dustin-lehmann/scioi-robochallenge-hub/hardware/rev1/docs/robochallenge-hub_rev1_schematics.pdf

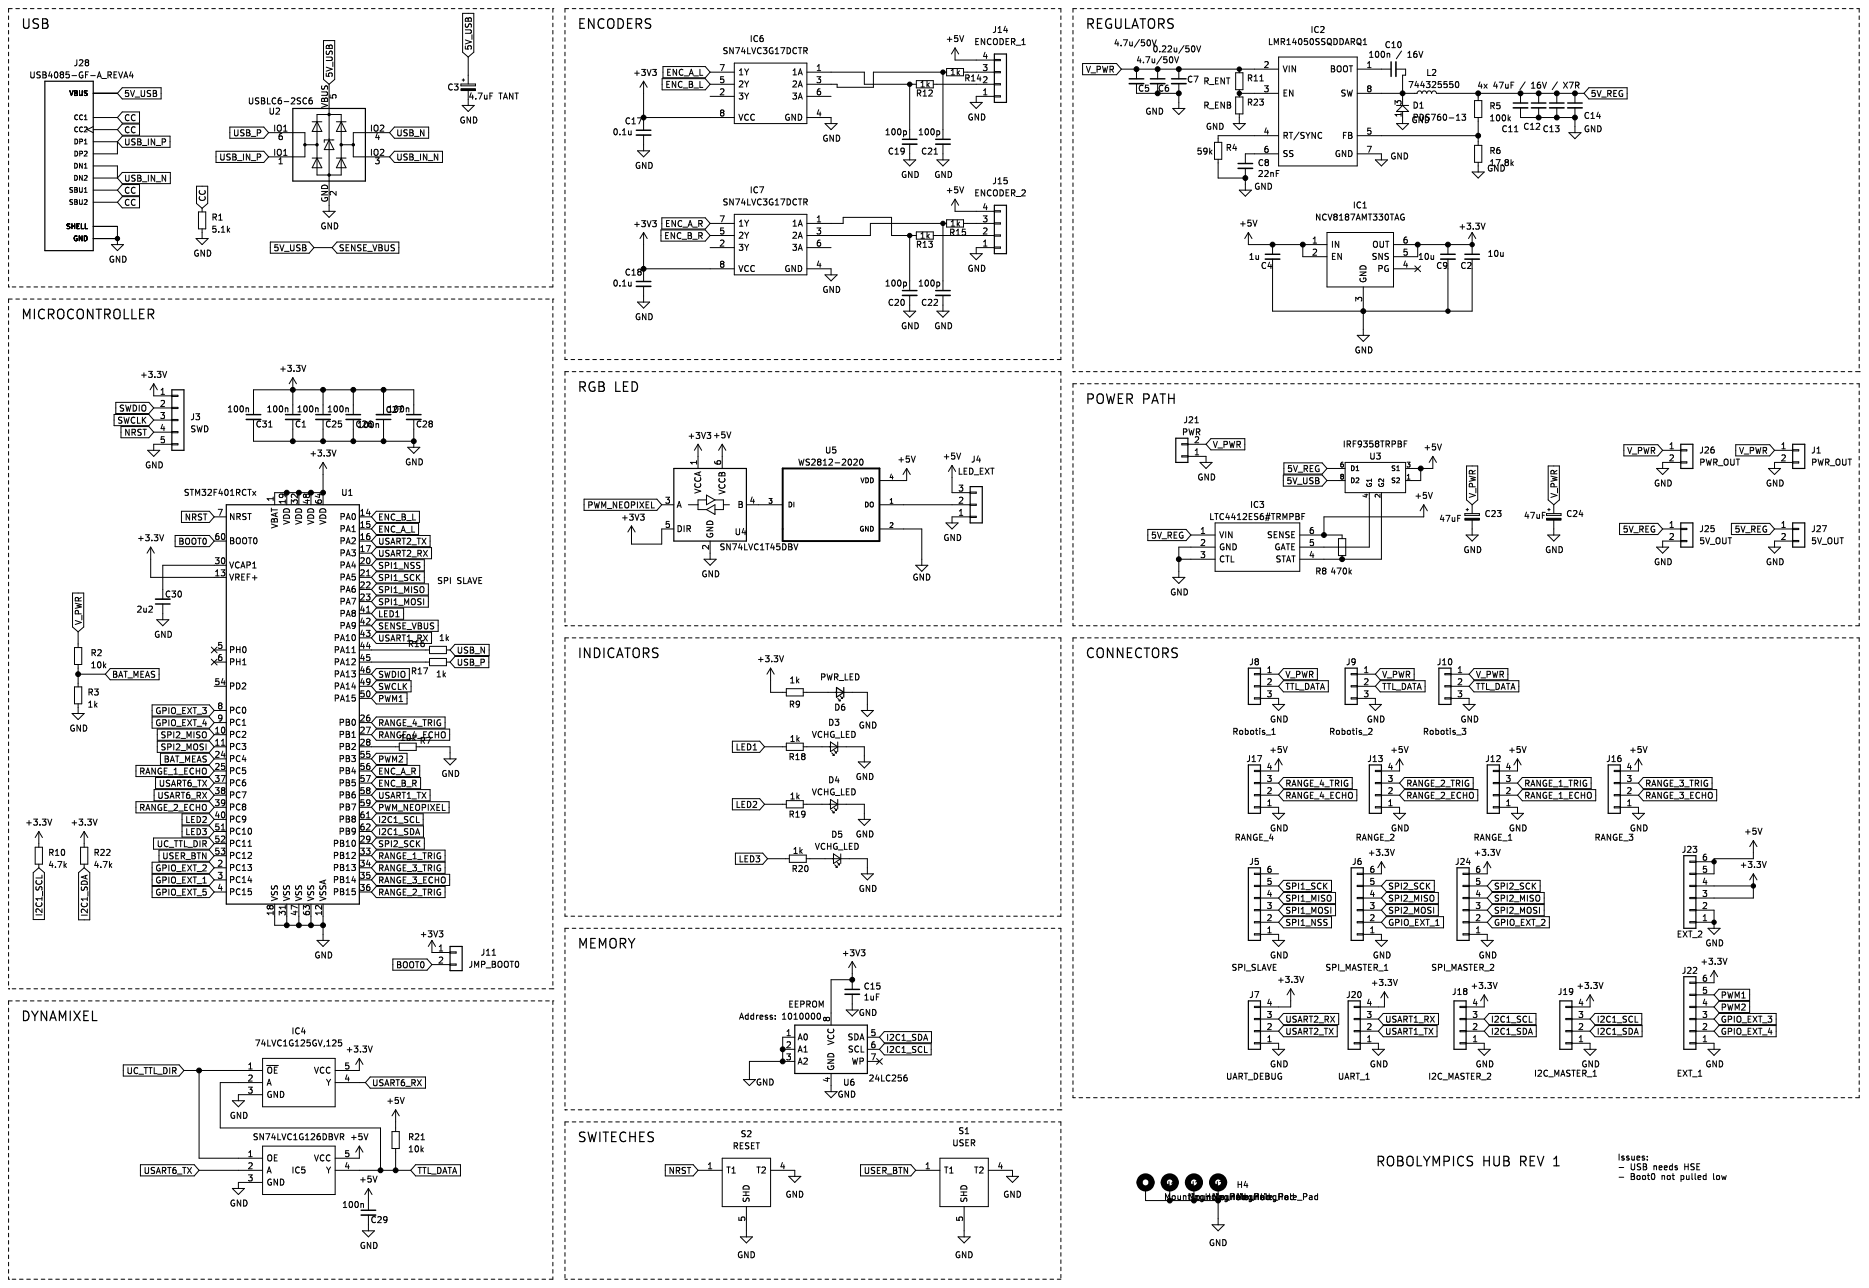
[picture p1: page 1]
