dustin-lehmann/scioi-robochallenge-hub/hardware/rev2/kicad/robolympics_hub_rev2.kicad_pcb

## KiCad design hardware/rev2/kicad/robolympics_hub_rev2.kicad_pcb (2022-03-09)

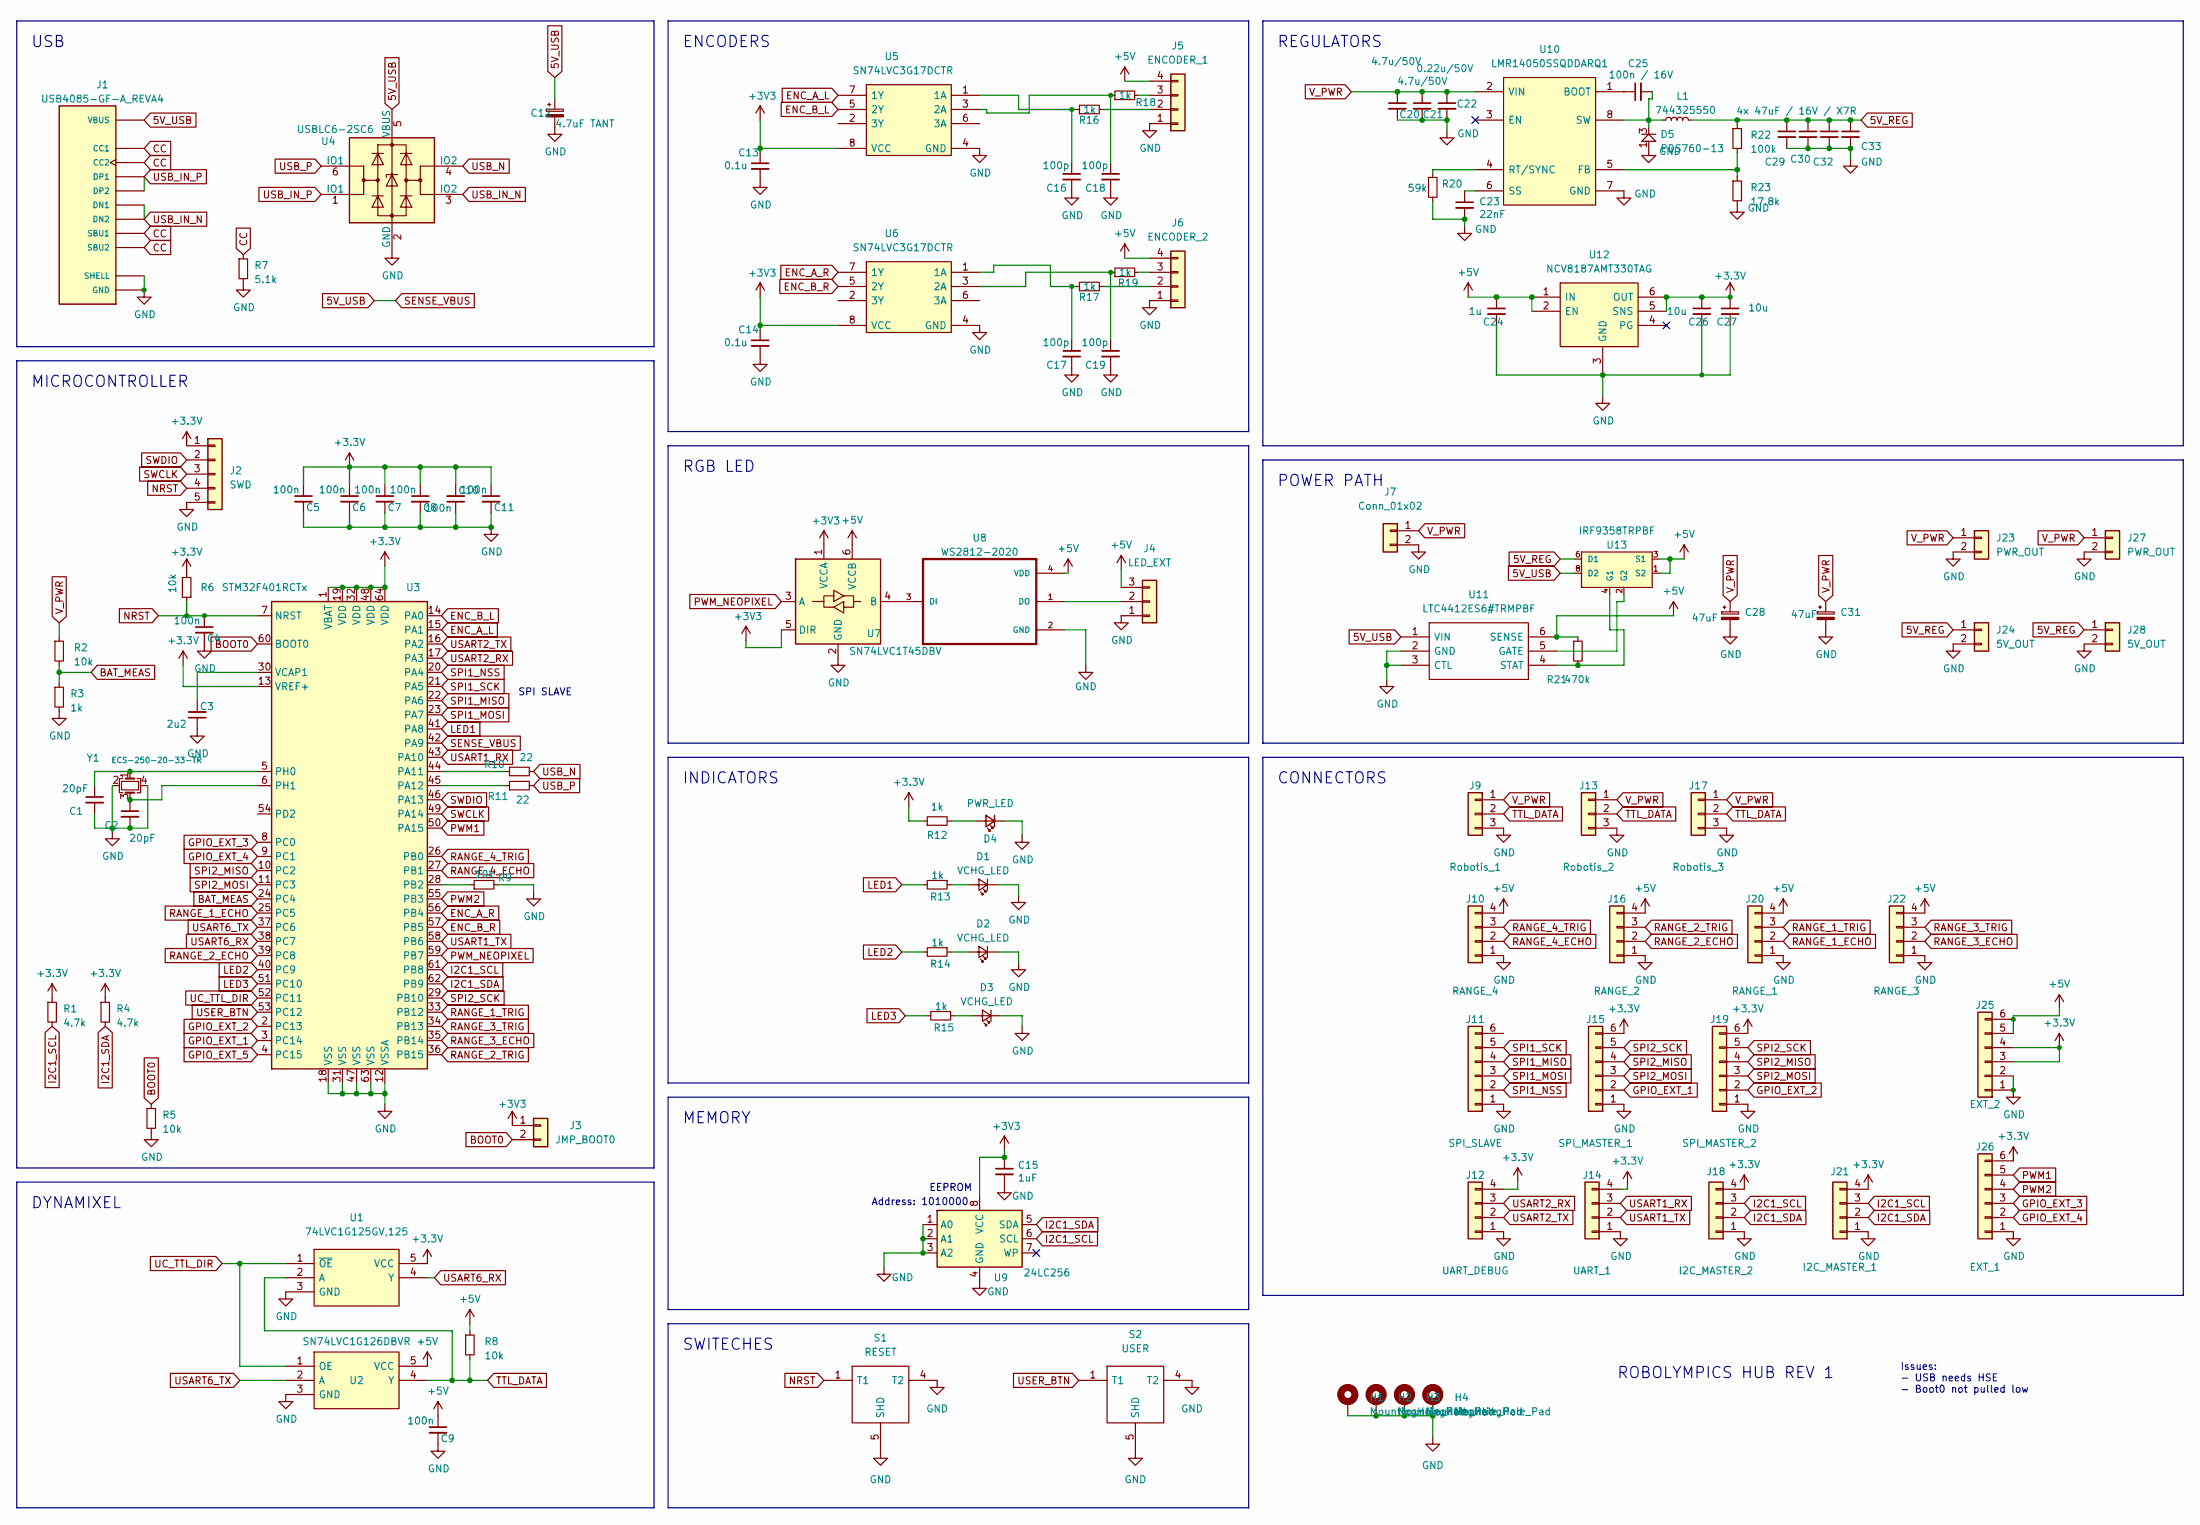
[picture p2: schematic robolympics_hub_rev2.kicad_sch]

Parts:
C1, C2: 20pF; C_0603_1608Metric
C3: 2u2; C_0805_2012Metric
C4, C5, C6, C7, C8, C9, C10, C11: 100n; C_0603_1608Metric
C12: 4.7uF TANT; C_1206_3216Metric
C13, C14: 0.1u; C_0603_1608Metric
C15: 1uF; C_0805_2012Metric
C16, C17, C18, C19: 100p; C_0603_1608Metric
C20, C21: 4.7u/50V; C_1210_3225Metric
C22: 0.22u/50V; C_0805_2012Metric
C23: 22nF; C_0603_1608Metric
C24: 1u; C_0805_2012Metric
C25: 100n / 16V; C_0603_1608Metric
C26, C27: 10u; C_0805_2012Metric
C28, C31: 47uF; CP_Elec_6.3x5.2
C29: 4x 47uF / 16V / X7R; C_1210_3225Metric
C30, C32, C33: C_Small; C_1210_3225Metric
D1, D2, D3: VCHG_LED; LED_0402_1005Metric
D4: PWR_LED; LED_0603_1608Metric
D5: PDS760-13; POWERDI5; Mouser Part Number 621-PDS760-F
H1, H2, H3, H4: MountingHole_Pad; MountingHole_2.7mm_M2.5_Pad
J1: USB4085-GF-A_REVA4; GCT_USB4085-GF-A_REVA4; PARTREV A4
J2: SWD; PinHeader_1x05_P2.54mm_Vertical
J3: JMP_BOOT0; PinHeader_1x02_P2.54mm_Vertical
J4: LED_EXT; Molex_KK-254_AE-6410-03A_1x03_P2.54mm_Vertical
J5: ENCODER_1; Molex_KK-254_AE-6410-04A_1x04_P2.54mm_Vertical
J6: ENCODER_2; Molex_KK-254_AE-6410-04A_1x04_P2.54mm_Vertical
J7: Conn_01x02; 691322310002
J9: Robotis_1; JST_EH_B3B-EH-A_1x03_P2.50mm_Vertical
J10: RANGE_4; Molex_KK-254_AE-6410-04A_1x04_P2.54mm_Vertical
J11: SPI_SLAVE; Molex_KK-254_AE-6410-06A_1x06_P2.54mm_Vertical
J12: UART_DEBUG; Molex_KK-254_AE-6410-04A_1x04_P2.54mm_Vertical
J13: Robotis_2; JST_EH_B3B-EH-A_1x03_P2.50mm_Vertical
J14: UART_1; Molex_KK-254_AE-6410-04A_1x04_P2.54mm_Vertical
J15: SPI_MASTER_1; Molex_KK-254_AE-6410-06A_1x06_P2.54mm_Vertical
J16: RANGE_2; Molex_KK-254_AE-6410-04A_1x04_P2.54mm_Vertical
J17: Robotis_3; JST_EH_B3B-EH-A_1x03_P2.50mm_Vertical
J18: I2C_MASTER_2; Molex_KK-254_AE-6410-04A_1x04_P2.54mm_Vertical
J19: SPI_MASTER_2; Molex_KK-254_AE-6410-06A_1x06_P2.54mm_Vertical
J20: RANGE_1; Molex_KK-254_AE-6410-04A_1x04_P2.54mm_Vertical
J21: I2C_MASTER_1; Molex_KK-254_AE-6410-04A_1x04_P2.54mm_Vertical
J22: RANGE_3; Molex_KK-254_AE-6410-04A_1x04_P2.54mm_Vertical
J23, J27: PWR_OUT; Molex_KK-254_AE-6410-02A_1x02_P2.54mm_Vertical
J24, J28: 5V_OUT; Molex_KK-254_AE-6410-02A_1x02_P2.54mm_Vertical
J25: EXT_2; Molex_KK-254_AE-6410-06A_1x06_P2.54mm_Vertical
J26: EXT_1; Molex_KK-254_AE-6410-06A_1x06_P2.54mm_Vertical
L1: 744325550; INDPM105102X500N
R1, R4: 4.7k; R_0603_1608Metric
R2, R5, R6, R8, R9: 10k; R_0603_1608Metric
R3, R12, R13, R14, R15, R16, R17, R18, R19: 1k; R_0603_1608Metric
R7: 5.1k; R_0603_1608Metric
R10, R11: 22; R_0603_1608Metric
R20: 59k; R_0603_1608Metric
R21: 470k; R_0603_1608Metric
R22: 100k; R_0603_1608Metric
R23: 17.8k; R_0603_1608Metric
S1: RESET; TL6330AF200Q; Mouser Part Number 612-TL6330AF200Q
S2: USER; TL6330AF200Q; Mouser Part Number 612-TL6330AF200Q
U1: 74LVC1G125GV,125; SOT95P275X110-5N; Mouser Part Number 771-74LVC1G125GV
U2: SN74LVC1G126DBVR; SOT95P275X110-5N; Mouser Part Number 595-SN74LVC1G126DBVR
U3: STM32F401RCTx; LQFP-64_10x10mm_P0.5mm
U4: USBLC6-2SC6; SOT-23-6
U5, U6: SN74LVC3G17DCTR; SOP65P400X130-8N; Mouser Part Number 595-SN74LVC3G17DCTR
U7: SN74LVC1T45DBV; SOT-23-6
U8: WS2812-2020; ws2812_2020
U9: 24LC256; DFN-8-1EP_6x5mm_P1.27mm_EP2x2mm
U10: LMR14050SSQDDARQ1; SOIC127P600X170-9N; Mouser Part Number 595-LMR14050SSDDARQ1
U11: LTC4412ES6#TRMPBF; SOT95P280X100-6N; Mouser Part Number 584-LTC4412ES6TRMPBF
U12: NCV8187AMT330TAG; SON65P200X200X80-7N; Mouser Part Number 863-NCV8187AMT120TAG
U13: IRF9358TRPBF; SOIC127P600X175-8N; MPN IRF9358TRPBF
Y1: ‎ECS-250-20-33-TR‎; ECS2501833BCKYTR

Connections:
5V_REG: C29.1, C30.1, C32.1, C33.1, J24.1, J28.1, L1.2, R22.1, U13.5 (D1_2), U13.6 (D1)
5V_USB: C12.1, J1.A4 (VBUS), J1.A9 (VBUS), J1.B4 (VBUS), J1.B9 (VBUS), U3.42 (PA9), U4.5 (VBUS), U11.1 (VIN), U13.7 (D2_2), U13.8 (D2)
+5V: C9.1, C24.1, J4.3, J5.4, J6.4, J10.4, J16.4, J20.4, J22.4, J25.5, J25.6, R8.1, R21.1, U2.5 (VCC), U7.6 (VCCB), U8.4 (VDD), U11.6 (SENSE), U12.1 (IN), U12.2 (EN), U13.1 (S2), U13.3 (S1)
BAT_MEAS: R2.2, R3.1, U3.24 (PC4)
BOOT0: J3.2, R5.1, U3.60 (BOOT0)
CC: J1.A5 (CC1), J1.A8 (SBU1), J1.B5 (CC2), J1.B8 (SBU2), R7.1
ENC_A_L: U3.15 (PA1), U5.7 (1Y)
ENC_A_R: U3.56 (PB4), U6.7 (1Y)
ENC_B_L: U3.14 (PA0), U5.5 (2Y)
ENC_B_R: U3.57 (PB5), U6.5 (2Y)
GND: C1.2, C2.2, C3.1, C4.2, C5.2, C6.2, C7.2, C8.2, C9.2, C10.1, C11.2, C12.2, C13.2, C14.2, C15.2, C16.2, C17.2, C18.2, C19.2, C20.2, C21.2, C22.2, C23.2, C24.2, C26.2, C27.2, C28.2, C29.2, C30.2, C31.2, C32.2, C33.2, D1.1 (K), D2.1 (K), D3.1 (K), D4.1 (K), D5.1, D5.2 (RIGHT_PIN), H1.1, H2.1, H3.1, H4.1, J1.A1 (GND), J1.A12 (GND), J1.B1 (GND), J1.B12 (GND), J1.P1 (SHELL), J1.P2 (SHELL), J1.P3 (SHELL), J1.P4 (SHELL), J2.5, J4.1, J5.1, J6.1, J7.2, J9.3, J10.1, J11.1, J12.1, J13.3, J14.1, J15.1, J16.1, J17.3, J18.1, J19.1, J20.1, J21.1, J22.1, J23.2, J24.2, J25.1, J25.2, J26.1, J27.2, J28.2, R3.2, R5.2, R7.2, R9.2, R20.2, R23.2, S1.3, S1.4 (T2), S1.5 (SHD), S2.3, S2.4 (T2), S2.5 (SHD), U1.3 (GND), U2.3 (GND), U3.12 (VSSA), U3.18 (VSS), U3.31 (VSS), U3.47 (VSS), U3.63 (VSS), U4.2 (GND), U5.4 (GND), U6.4 (GND), U7.2 (GND), U8.2 (GND), U9.1 (A0), U9.2 (A1), U9.3 (A2), U9.4 (GND), U10.7 (GND), U10.9 (GND_2), U11.2 (GND), U11.3 (CTL), U12.3 (GND), U12.7 (GND), Y1.2, Y1.4
GPIO_EXT_1: J15.2, U3.3 (PC14)
GPIO_EXT_2: J19.2, U3.2 (PC13)
GPIO_EXT_3: J26.3, U3.8 (PC0)
GPIO_EXT_4: J26.2, U3.9 (PC1)
GPIO_EXT_5: U3.4 (PC15)
I2C1_SCL: J18.3, J21.3, R1.2, U3.61 (PB8), U9.6 (SCL)
I2C1_SDA: J18.2, J21.2, R4.2, U3.62 (PB9), U9.5 (SDA)
LED1: R13.2, U3.41 (PA8)
LED2: R14.2, U3.40 (PC9)
LED3: R15.2, U3.51 (PC10)
NRST: C4.1, J2.4, R6.1, S1.1 (T1), S1.2, U3.7 (NRST)
unnamed: C1.1, U3.5 (PH0), Y1.1
unnamed: C2.1, U3.6 (PH1), Y1.3
unnamed: C3.2, U3.30 (VCAP1)
unnamed: C16.1, R16.1, U5.1 (1A)
unnamed: C17.1, R17.1, U6.1 (1A)
unnamed: C18.1, R18.1, U5.3 (2A)
unnamed: C19.1, R19.1, U6.3 (2A)
unnamed: C23.1, U10.6 (SS)
unnamed: C25.1, U10.1 (BOOT)
unnamed: C25.2, D5.3, L1.1, U10.8 (SW)
unnamed: D1.2 (A), R13.1
unnamed: D2.2 (A), R14.1
unnamed: D3.2 (A), R15.1
unnamed: D4.2 (A), R12.2
unnamed: J4.2, U8.1 (DO)
unnamed: J5.2, R16.2
unnamed: J5.3, R18.2
unnamed: J6.2, R17.2
unnamed: J6.3, R19.2
unnamed: R9.1, U3.28 (PB2)
unnamed: R10.1, U3.44 (PA11)
unnamed: R11.1, U3.45 (PA12)
unnamed: R20.1, U10.4 (RT/SYNC)
unnamed: R21.2, U11.4 (STAT), U13.4 (G1)
unnamed: R22.2, R23.1, U10.5 (FB)
unnamed: U7.4 (B), U8.3 (DI)
unnamed: U11.5 (GATE), U13.2 (G2)
PWM1: J26.5, U3.50 (PA15)
PWM2: J26.4, U3.55 (PB3)
PWM_NEOPIXEL: U3.59 (PB7), U7.3 (A)
RANGE_1_ECHO: J20.2, U3.25 (PC5)
RANGE_1_TRIG: J20.3, U3.33 (PB12)
RANGE_2_ECHO: J16.2, U3.39 (PC8)
RANGE_2_TRIG: J16.3, U3.36 (PB15)
RANGE_3_ECHO: J22.2, U3.35 (PB14)
RANGE_3_TRIG: J22.3, U3.34 (PB13)
RANGE_4_ECHO: J10.2, U3.27 (PB1)
RANGE_4_TRIG: J10.3, U3.26 (PB0)
SPI1_MISO: J11.4, U3.22 (PA6)
SPI1_MOSI: J11.3, U3.23 (PA7)
SPI1_NSS: J11.2, U3.20 (PA4)
SPI1_SCK: J11.5, U3.21 (PA5)
SPI2_MISO: J15.4, J19.4, U3.10 (PC2)
SPI2_MOSI: J15.3, J19.3, U3.11 (PC3)
SPI2_SCK: J15.5, J19.5, U3.29 (PB10)
SWCLK: J2.3, U3.49 (PA14)
SWDIO: J2.2, U3.46 (PA13)
TTL_DATA: J9.2, J13.2, J17.2, R8.2, U1.2 (A), U2.4 (Y)
UC_TTL_DIR: U1.1 (~OE), U2.1 (OE), U3.52 (PC11)
USART1_RX: J14.3, U3.43 (PA10)
USART1_TX: J14.2, U3.58 (PB6)
USART2_RX: J12.3, U3.17 (PA3)
USART2_TX: J12.2, U3.16 (PA2)
USART6_RX: U1.4 (Y), U3.38 (PC7)
USART6_TX: U2.2 (A), U3.37 (PC6)
USB_IN_N: J1.A7 (DN1), J1.B7 (DN2), U4.3 (IO2)
USB_IN_P: J1.A6 (DP1), J1.B6 (DP2), U4.1 (IO1)
USB_N: R10.2, U4.4 (IO2)
USB_P: R11.2, U4.6 (IO1)
USER_BTN: S2.1 (T1), S2.2, U3.53 (PC12)
V_PWR: C20.1, C21.1, C22.1, C28.1, C31.1, J7.1, J9.1, J13.1, J17.1, J23.1, J27.1, R2.1, U10.2 (VIN)

Notes on the sheet:
EEPROM
SWITECHES
REGULATORS
CONNECTORS
Issues: - USB needs HSE - Boot0 not pulled low
Address: 1010000
RGB LED
MICROCONTROLLER
MEMORY
POWER PATH
INDICATORS
ROBOLYMPICS HUB REV 1
DYNAMIXEL
USB
SPI SLAVE
ENCODERS

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
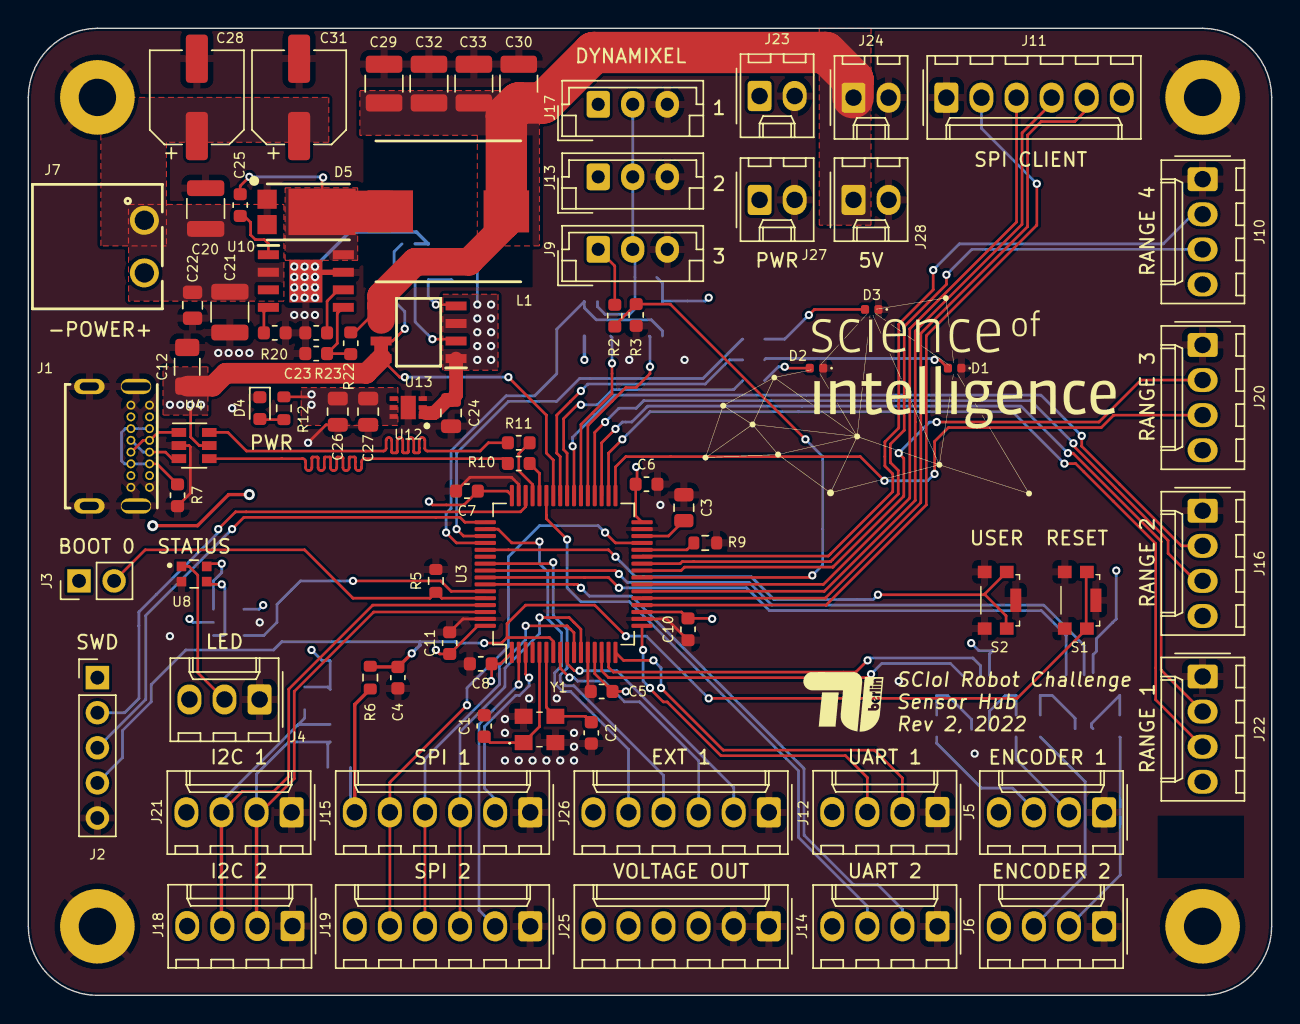
[picture p3: board robolympics_hub_rev2.kicad_pcb from above]

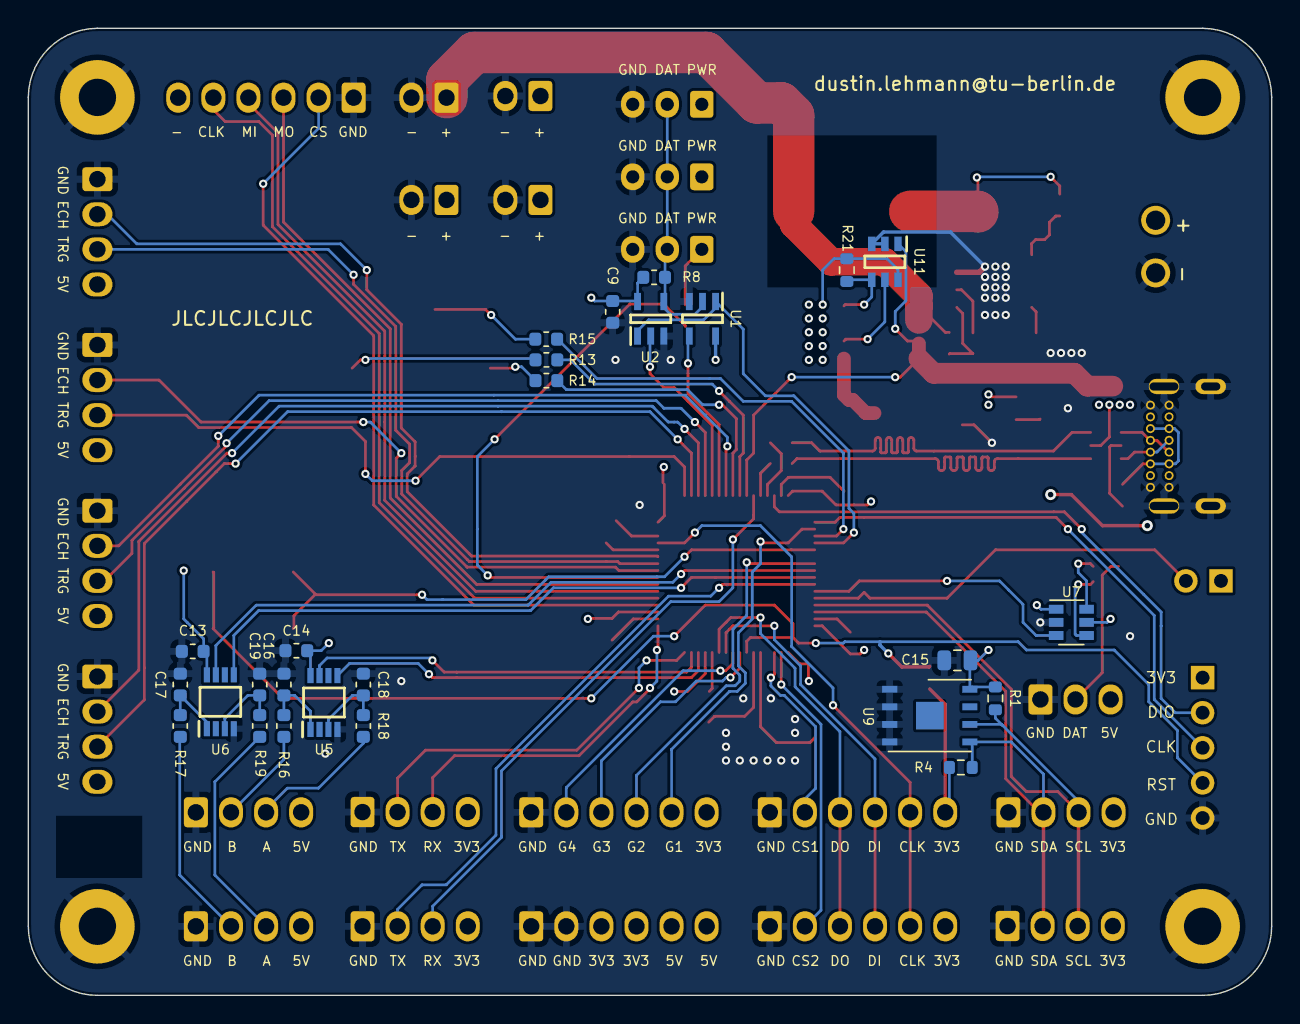
[picture p4: board robolympics_hub_rev2.kicad_pcb from below]

Board: 4 copper layers, 90.0 x 70.0 mm, 109 parts (26 on the bottom side), 83 nets.
