dustin-lehmann/scioi-robochallenge-hub/firmware/Core/Src/main.c

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
/* Includes ------------------------------------------------------------------*/
#include "main.h"
#include "cmsis_os.h"
#include "usb_device.h"

/* USER CODE BEGIN Includes */
#include "firmware.h"

/* USER CODE END Includes */

 TIM_HandleTypeDef htim3;
TIM_HandleTypeDef htim4;
DMA_HandleTypeDef hdma_tim4_ch2;

/* Definitions for test_task */
osThreadId_t test_taskHandle;
const osThreadAttr_t test_task_attributes = {
  .name = "test_task",
  .stack_size = 128 * 4,
  .priority = (osPriority_t) osPriorityNormal,
};
/* Definitions for DistanceSensorT */
osThreadId_t DistanceSensorTHandle;
const osThreadAttr_t DistanceSensorT_attributes = {
  .name = "DistanceSensorT",
  .stack_size = 128 * 4,
  .priority = (osPriority_t) osPriorityLow,
};
/* Definitions for streaming_task */
osThreadId_t streaming_taskHandle;
const osThreadAttr_t streaming_task_attributes = {
  .name = "streaming_task",
  .stack_size = 128 * 4,
  .priority = (osPriority_t) osPriorityLow,
};
void SystemClock_Config(void);
static void MX_GPIO_Init(void);
static void MX_DMA_Init(void);
static void MX_TIM4_Init(void);
static void MX_TIM3_Init(void);
void test_task_fun(void *argument);
void DistanceSensorTask_Init(void *argument);
void streaming_task_entry(void *argument);

/**
  * @brief  The application entry point.
  * @retval int
  */
int main(void)
{
  /* MCU Configuration--------------------------------------------------------*/

  /* Reset of all peripherals, Initializes the Flash interface and the Systick. */
  HAL_Init();

  /* Configure the system clock */
  SystemClock_Config();

  /* Initialize all configured peripherals */
  MX_GPIO_Init();
  MX_DMA_Init();
  MX_TIM4_Init();
  MX_TIM3_Init();
  /* USER CODE BEGIN 2 */
	//Timer used for distance Sensors
	distance_sensor_timer = &htim3;

	ws2812_init(&htim4);

	firmware_init();
  /* USER CODE END 2 */

  /* Init scheduler */
  osKernelInitialize();

  /* USER CODE BEGIN RTOS_MUTEX */
	/* add mutexes, ... */
  /* USER CODE END RTOS_MUTEX */

  /* USER CODE BEGIN RTOS_SEMAPHORES */
	/* add semaphores, ... */
  /* USER CODE END RTOS_SEMAPHORES */

  /* USER CODE BEGIN RTOS_TIMERS */
	/* start timers, add new ones, ... */
  /* USER CODE END RTOS_TIMERS */

  /* USER CODE BEGIN RTOS_QUEUES */
	/* add queues, ... */
  /* USER CODE END RTOS_QUEUES */

  /* Create the thread(s) */
  /* creation of test_task */
  test_taskHandle = osThreadNew(test_task_fun, NULL, &test_task_attributes);

  /* creation of DistanceSensorT */
  DistanceSensorTHandle = osThreadNew(DistanceSensorTask_Init, NULL, &DistanceSensorT_attributes);

  /* creation of streaming_task */
  streaming_taskHandle = osThreadNew(streaming_task_entry, NULL, &streaming_task_attributes);

  /* USER CODE BEGIN RTOS_THREADS */
	/* add threads, ... */
  /* USER CODE END RTOS_THREADS */

  /* USER CODE BEGIN RTOS_EVENTS */
	/* add events, ... */
  /* USER CODE END RTOS_EVENTS */

  /* Start scheduler */
  osKernelStart();

  /* We should never get here as control is now taken by the scheduler */
  /* Infinite loop */
  /* USER CODE BEGIN WHILE */
	while (1) {
    /* USER CODE END WHILE */

    /* USER CODE BEGIN 3 */
	}
  /* USER CODE END 3 */
}

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
/* USER CODE BEGIN Header_test_task_fun */
/**
 * @brief  Function implementing the test_task thread.
 * @param  argument: Not used
 * @retval None
 */
/* USER CODE END Header_test_task_fun */
void test_task_fun(void *argument)
{
  /* init code for USB_DEVICE */
  MX_USB_DEVICE_Init();
  /* USER CODE BEGIN 5 */
	/* Infinite loop */
	for (;;) {
		osDelay(250);
	}
  /* USER CODE END 5 */
}

/* USER CODE BEGIN Header_DistanceSensorTask_Init */
/**
 * @brief Function implementing the DistanceSensorT thread.
 * @param argument: Not used
 * @retval None
 */
/* USER CODE END Header_DistanceSensorTask_Init */
void DistanceSensorTask_Init(void *argument)
{
  /* USER CODE BEGIN DistanceSensorTask_Init */
	distance_meas_task(&distance_sensor_handler);
  /* USER CODE END DistanceSensorTask_Init */
}

/* USER CODE BEGIN Header_streaming_task_entry */
/**
* @brief Function implementing the streaming_task thread.
* @param argument: Not used
* @retval None
*/
/* USER CODE END Header_streaming_task_entry */
void streaming_task_entry(void *argument)
{
  /* USER CODE BEGIN streaming_task_entry */
  /* Infinite loop */
  for(;;)
  {

	  // Send all distance sensors
	  for (int i=0;i<distance_sensor_handler.num_sensors; i++){
		  msg_stream_distance(msg_out_buf, distance_sensor_handler.distance_sensors[i]);
	  }
    osDelay(100);
  }
  /* USER CODE END streaming_task_entry */
}

/**
  * @brief  Period elapsed callback in non blocking mode
  * @note   This function is called  when TIM11 interrupt took place, inside
  * HAL_TIM_IRQHandler(). It makes a direct call to HAL_IncTick() to increment
  * a global variable "uwTick" used as application time base.
  * @param  htim : TIM handle
  * @retval None
  */
void HAL_TIM_PeriodElapsedCallback(TIM_HandleTypeDef *htim)
{
  if (htim->Instance == TIM11) {
    HAL_IncTick();
  }
  /* USER CODE BEGIN Callback 1 */
	if (htim->Instance == TIM3) {
		distance_sensor_timer_callback();
	}
  /* USER CODE END Callback 1 */
}

/**
  * @brief  This function is executed in case of error occurrence.
  * @retval None
  */
void Error_Handler(void)
{
  /* USER CODE BEGIN Error_Handler_Debug */
	/* User can add his own implementation to report the HAL error return state */
	__disable_irq();
	while (1) {
	}
  /* USER CODE END Error_Handler_Debug */
}

#ifdef  USE_FULL_ASSERT
/**
  * @brief  Reports the name of the source file and the source line number
  *         where the assert_param error has occurred.
  * @param  file: pointer to the source file name
  * @param  line: assert_param error line source number
  * @retval None
  */
void assert_failed(uint8_t *file, uint32_t line)
{
  /* USER CODE BEGIN 6 */
  /* User can add his own implementation to report the file name and line number,
     ex: printf("Wrong parameters value: file %s on line %d\r\n", file, line) */
  /* USER CODE END 6 */
}
#endif /* USE_FULL_ASSERT */
