dustin-lehmann/scioi-robochallenge-hub/firmware/firmware/common.h

/*
 * common.h
 *
 *  Created on: 13 Feb 2022
 *      Author: Dustin Lehmann
 */

#ifndef COMMON_H_
#define COMMON_H_

#include <stdint.h>

extern void error_handler(uint8_t error_id);


#endif /* COMMON_H_ */
