dustin-lehmann/scioi-robochallenge-hub/(commit log)

2022-03-09 - uploaded schematics for rev1
2022-03-15 - added distance sensors and streaming messages
2022-03-17 - bugfix for distance sensors
    [distance.c]
